santiagorobaldi/Arturito/DocumentacionLatex/avance-santi-2.tex

% Sección incluida desde ARTURITO MAIN.tex con \input{explicando_firmware.tex}.
% Mantener este archivo como fragmento: no agregar preámbulo ni \begin{document}.

% =============================================================================
\section{Diseño del firmware, simulación y depuración}
\label{sec:diseno-firmware}
% =============================================================================

\subsection{Alcance y arquitectura elegida}

El firmware actual corresponde a una primera versión de percepción (V0). En
esta etapa adquiere la velocidad angular del eje $Z$ de una IMU MPU6050 y una
distancia del sensor ToF VL53L0X, procesa ambas mediciones y transmite el estado
por el puerto serie. El ángulo se obtiene integrando el giroscopio; por ello
puede acumular deriva y no representa una pose absoluta.

La arquitectura es modular, organizada en tres capas, y utiliza tareas
periódicas planificadas por FreeRTOS. No es una arquitectura disparada por
eventos: las tareas repiten su ciclo con un período nominal de
\texttt{SAMPLE\_PERIOD\_MS = 30 ms}. FreeRTOS tiene planificación apropiativa por
prioridades; cada tarea cede el procesador al bloquearse durante la espera. La
adquisición de sensores y el procesamiento no quedan sincronizados en fase, por
lo que los 30 ms son un período nominal y no una garantía de latencia exacta.

\begin{center}
\fbox{\parbox{0.94\linewidth}{\centering
Sensores (I2C) $\rightarrow$ HAL de la placa $\rightarrow$ drivers compartidos
$\rightarrow$ tareas FreeRTOS $\rightarrow$ HAL serie $\rightarrow$ USB/UART
$\rightarrow$ Processing}}
\end{center}

El ciclo de operación puede resumirse con el siguiente pseudocódigo:

\begin{enumerate}
  \item Iniciar la consola serie y crear la tarea de arranque.
  \item Inicializar la MPU6050 y el VL53L0X mediante sus respectivas HAL.
  \item Si la IMU no responde, informar el error y no iniciar la adquisición.
        Si el ToF no responde, continuar e indicar distancia inválida.
  \item Calibrar el offset del giroscopio con el robot quieto y crear los
        mutexes que protegen las muestras compartidas.
  \item Crear las tareas periódicas de adquisición, procesamiento y publicación.
  \item Repetir: leer gyro Z y distancia; guardar una instantánea protegida;
        corregir e integrar gyro para estimar $\theta$; validar distancia;
        transmitir $\theta$ y distancia como una línea CSV.
\end{enumerate}

\subsection{Capas y módulos del firmware}

\begin{description}
  \item[Capa 1 --- HAL de hardware.] Los contratos comunes están en
        \texttt{shared/layer1\_hal/}. Las implementaciones específicas están en
        \texttt{esp32/src/layer1\_hal/} y
        \texttt{edu-ciaa/rover/src/layer1\_hal/}. La HAL de IMU inicializa y lee
        gyro Z en rad/s; la HAL ToF inicializa y devuelve metros o $-1$ si no hay
        una medida disponible; las HAL de tiempo y telemetría adaptan el reloj,
        las esperas y la salida serie de cada placa.
  \item[Capa 2 --- drivers.] Los módulos comunes
        \texttt{shared/layer2\_drivers/driver\_mpu6050.c} y
        \texttt{driver\_distancia.c} no acceden directamente a los periféricos.
        El primero promedia 1000 muestras para estimar el offset, aplica una
        zona muerta de $1^\circ$/s e integra gyro Z mediante integración
        trapezoidal. El segundo acepta distancias entre 0,05 m y 1,50 m,
        inclusive; fuera de ese intervalo informa $-1$.
  \item[Capa 3 --- aplicación.] \texttt{shared/layer3\_app/app\_runtime.c}
        inicializa el sistema, gestiona el estado y crea las tareas. La tarea
        \texttt{adquirir} obtiene las muestras de los sensores; \texttt{drivers}
        procesa la última muestra; y \texttt{publicar} genera la trama serie.
        Dos mutexes protegen las copias de datos crudos y procesados. La tarea
        de arranque inicializa sensores, calibra la IMU y crea las tareas
        cíclicas.
\end{description}

Las prioridades configuradas son 4 para arranque, 3 para adquisición, 2 para
procesamiento y 1 para publicación. Al terminar la inicialización, la tarea de
arranque se elimina. En ESP32, Arduino ya inició FreeRTOS antes de ejecutar
\texttt{setup()}; en EDU-CIAA, \texttt{main()} crea la tarea de arranque y luego
llama al scheduler.

\subsection{Bibliotecas y herramientas externas}

\begin{itemize}
  \item \textbf{ESP32:} framework Arduino para PlatformIO; FreeRTOS provisto
        por el entorno ESP32; \texttt{Wire} para el bus I2C; y biblioteca
        \texttt{Adafruit\_VL53L0X} para el ToF.
  \item \textbf{EDU-CIAA:} LPCOpen y SAPI para la placa y los periféricos,
        junto con el kernel FreeRTOS configurado en el proyecto. La HAL del
        VL53L0X realiza el acceso por registros I2C, sin depender de la
        biblioteca de Adafruit.
  \item \textbf{Código del proyecto:} contratos HAL, drivers MPU6050 y ToF, y
        runtime de aplicación compartidos entre plataformas. No se utiliza
        actualmente un RTOS del proyecto CIAA distinto de FreeRTOS.
  \item \textbf{PC:} Processing y su biblioteca Serial reciben la telemetría
        por USB/UART y dibujan la orientación y las lecturas de distancia.
\end{itemize}

\subsection{Formato de comunicación con el programa de PC}

El firmware de aplicación transmite a 115200 baudios una línea por muestra con
dos campos numéricos separados por coma:

\begin{center}
\texttt{theta\_rad,distancia\_m}
\end{center}

El ángulo se expresa en radianes y la distancia en metros. Las líneas de estado
y error comienzan con \texttt{\#}; el sketch de visualización las descarta. Una
distancia inválida se representa con $-1$. Este formato es un protocolo serie
de prueba V0, sin número de secuencia ni marca de tiempo.

\subsection{Interfaz de usuario y flujo de estados}

La interfaz de usuario actual es el sketch
\texttt{processing/flecha\_y\_mapa\_v1/flecha\_y\_mapa\_v1.pde}. No envía
órdenes al robot: presenta la orientación estimada, la distancia medida y una
nube polar acumulada de hasta 400 puntos. Los puntos se calculan respecto de un
origen fijo, suponiendo que el robot gira en el lugar. Por lo tanto, esta
interfaz permite observar sensores y telemetría, pero no muestra una grilla de
ocupación ni un mapa métrico con pose XY.

\begin{center}
\fbox{\parbox{0.88\linewidth}{\centering
Inicio del sketch $\rightarrow$ selección/configuración del puerto serie
$\rightarrow$ espera de tramas $\rightarrow$ \{línea de estado: actualizar
estado; trama CSV válida: dibujar orientación y distancia; trama inválida:
descartar\} $\rightarrow$ continuar recibiendo}}
\end{center}

El control START/STOP, la teleoperación y la selección entre navegación manual
y autónoma pertenecen a objetivos posteriores. No forman parte de la interfaz
ni del firmware V0 implementado.

\subsection{Ensayos, simulación y depuración}

La verificación realizada hasta ahora es experimental con el hardware y por
consola serie; no se cuenta con una simulación eléctrica o de movimiento del
rover. Para aislar periféricos existen entornos de prueba PlatformIO
\texttt{imu\_only}, \texttt{tof\_only} e \texttt{imu\_compare}. Este último
transmite tres campos (velocidad angular cruda, ángulo crudo integrado y ángulo
procesado) y se utiliza con
\texttt{processing/imu\_compare/imu\_compare.pde} para visualizar la diferencia
entre ambas integraciones. Ese formato de tres columnas es exclusivo de la
prueba y no coincide con el CSV de dos columnas de la aplicación V0.

El sketch \texttt{flecha\_y\_mapa\_v1} consume el CSV de la aplicación normal.
El monitor serie de PlatformIO debe cerrarse antes de abrir Processing, porque
ambos programas no pueden utilizar el mismo puerto simultáneamente. Los mensajes
de arranque permiten distinguir la inicialización de la IMU, el ToF, la
calibración y los errores.

Según el registro de avance del proyecto, los entornos de ESP32
\texttt{esp32dev}, \texttt{imu\_only} y \texttt{tof\_only} compilan, y una
versión anterior del firmware ESP32 fue probada con Processing. La versión
actualizada con runtime FreeRTOS compartido requiere confirmar nuevamente la
telemetría en serie después de su última modificación. El firmware EDU-CIAA
compila y enlaza, pero todavía no fue cargado ni ensayado con sensores en la
placa. No se incluyen capturas de resultados porque no hay imágenes de ensayos
registradas en los archivos del informe al momento de esta redacción.

\subsection{Alcance pendiente}

El firmware actual no implementa encoders, odometría de traslación, control de
motores, navegación autónoma, grilla de ocupación ni SLAM. El sensor ToF entrega
una medición puntual; el barrido angular mecánico y la asociación de cada medida
con una pose global deberán incorporarse para construir el mapa previsto. La
interfaz de usuario deberá ampliarse cuando se implementen los comandos remotos
y la visualización de dicho mapa.
