santiagorobaldi/Arturito/docs/ARTURITO MAIN.tex

\documentclass[12pt,a4paper]{article}
\usepackage[T1]{fontenc}
\usepackage[utf8]{inputenc}
\usepackage[spanish]{babel}
\usepackage{geometry}
\usepackage{graphicx}
\usepackage{xcolor}     % Para cuadros de texto y colores
\usepackage{tcolorbox} % Para cuadros de texto llamativos
\usepackage{microtype}  % Mejora la justificación tipográfica
\usepackage{caption}    % Personalización de pies de foto/figura
\usepackage{fancyhdr}   % Control de encabezados y pies de página
\usepackage{hyperref}   % Siempre se recomienda cargarlo al final del preámbulo
\usepackage{amsmath}    % Para \text en modo matemático
\usepackage{parskip}

% Configuración de márgenes
\geometry{
    top=2.5cm,
    bottom=2.5cm,
    left=3cm,
    right=2.5cm,
    headheight=15pt % <--- Agrega esta línea para eliminar el warning
}

% Definición de un rojo académico/elegante
\definecolor{rojoObjetivo}{RGB}{180, 40, 40}

% Configuración de formato para pies de figuras
\captionsetup{font=small, labelfont=bf}

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

% Configuración de hipervínculos
\hypersetup{
    colorlinks=true,
    linkcolor=black,
    urlcolor=blue,
    citecolor=black
}

\begin{document}
% Desactivar la división de palabras (hiphenación)
\hyphenpenalty=10000
\exhyphenpenalty=10000

% Permitir mayor flexibilidad en los espacios interpalabra para mantener el texto justificado
\tolerance=1000
\emergencystretch=3em

% ==============================================================================
% PORTADA / CARÁTULA PERSONALIZADA
% ==============================================================================
\begin{titlepage}
    \thispagestyle{empty}
    \centering

    \vspace*{1.5cm}

    % TÍTULO DEL INFORME
   {\huge \bfseries Arturito\\[0.3em] Rover autónomo diferencial mapeador \par}

    \vfill % Empuja el contenido hacia la parte inferior

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

    \vspace{1.5cm}

    % DATOS DE LA UNIVERSIDAD, DEPARTAMENTO Y FECHA
    \hrule height 0.5pt % Línea divisoria sutil
    \vspace{0.4cm}

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

\end{titlepage}

% ==============================================================================
% ÍNDICE GENERAL
% ==============================================================================
\pagenumbering{arabic}
\tableofcontents
\newpage

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

\newpage

% ==============================================================================
% SECCIÓN 2: OBJETIVOS
% ==============================================================================
\section{Objetivos}

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

% Recuadro destacado para la nota de los bloques en rojo
\noindent\fcolorbox{red!40}{red!5}{%
    \parbox{\dimexpr\linewidth-2\fboxsep-2\fboxrule\relax}{%
        \textbf{Nota:} Los bloques resaltados en \textcolor{red}{\textbf{rojo}} dentro del diagrama corresponden a funcionalidades clasificadas como \textbf{objetivos secundarios} del proyecto.
    }%
}
\vspace{0.4cm}

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

    \item \textbf{Bloque de Tracción y Actuación:} Recibe por parte del \textbf{Bloque de Procesamiento Central} comandos para regular la velocidad deseada de las ruedas, conviertiendo estas señales en tensión y corriente directas de la batería a los motores de dichas ruedas.
    \item \textbf{Bloque de Procesamiento Central:} Parte funcional del sistema encargada de: mapeo y estimación de posición, navegación y cinemática.

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

% ==============================================================================
% SECCIÓN 3: REQUERIMIENTOS
% ==============================================================================
\section{Requerimientos}

\subsection{Funcionales}

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

\end{itemize}

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

\subsection{No Funcionales}

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

\subsubsection{Restricciones Físicas}
\begin{itemize}
    \item El robot debe desplazarse a una velocidad lineal regulable entre \textit{[VelocidadMin]} y \textit{[VelocidadMax]}.
    \item El robot debe operar sobre pisos planos en interiores.
    \item El robot debe operar en un entorno donde los obstáculos tengan un mínimo de altura \textit{[AlturaMinObstaculos]}.
\end{itemize}
% ==============================================================================
% SECCIÓN 4: Cronograma Preliminar
% ==============================================================================
\section{Cronograma Preliminar}
% Agregar en el preámbulo si no los tenés:
% \usepackage{tcolorbox}
% \usepackage{hyperref}

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

% ==============================================================================
% SECCIÓN 5: División de Tareas del Grupo
% ==============================================================================
\section{División de Tareas del Grupo}

\begin{tcolorbox}[colframe=green!60!black, colback=green!5!white, arc=2mm, title=\textbf{División de tareas (Google Sheets)}]
  En el siguiente enlace podrá acceder a una plantilla con los modulos y requerimientos a realizar por integrante:
  \vspace{0.2cm}

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

% ==============================================================================
% SECCIÓN 5: Bibliografía
% ==============================================================================
\section{Bibliografía}

\begin{thebibliography}{99}

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

\end{thebibliography}

\end{document}
