santiagorobaldi/Arturito/DocumentacionLatex/Imagenes/Esquematico.pdf

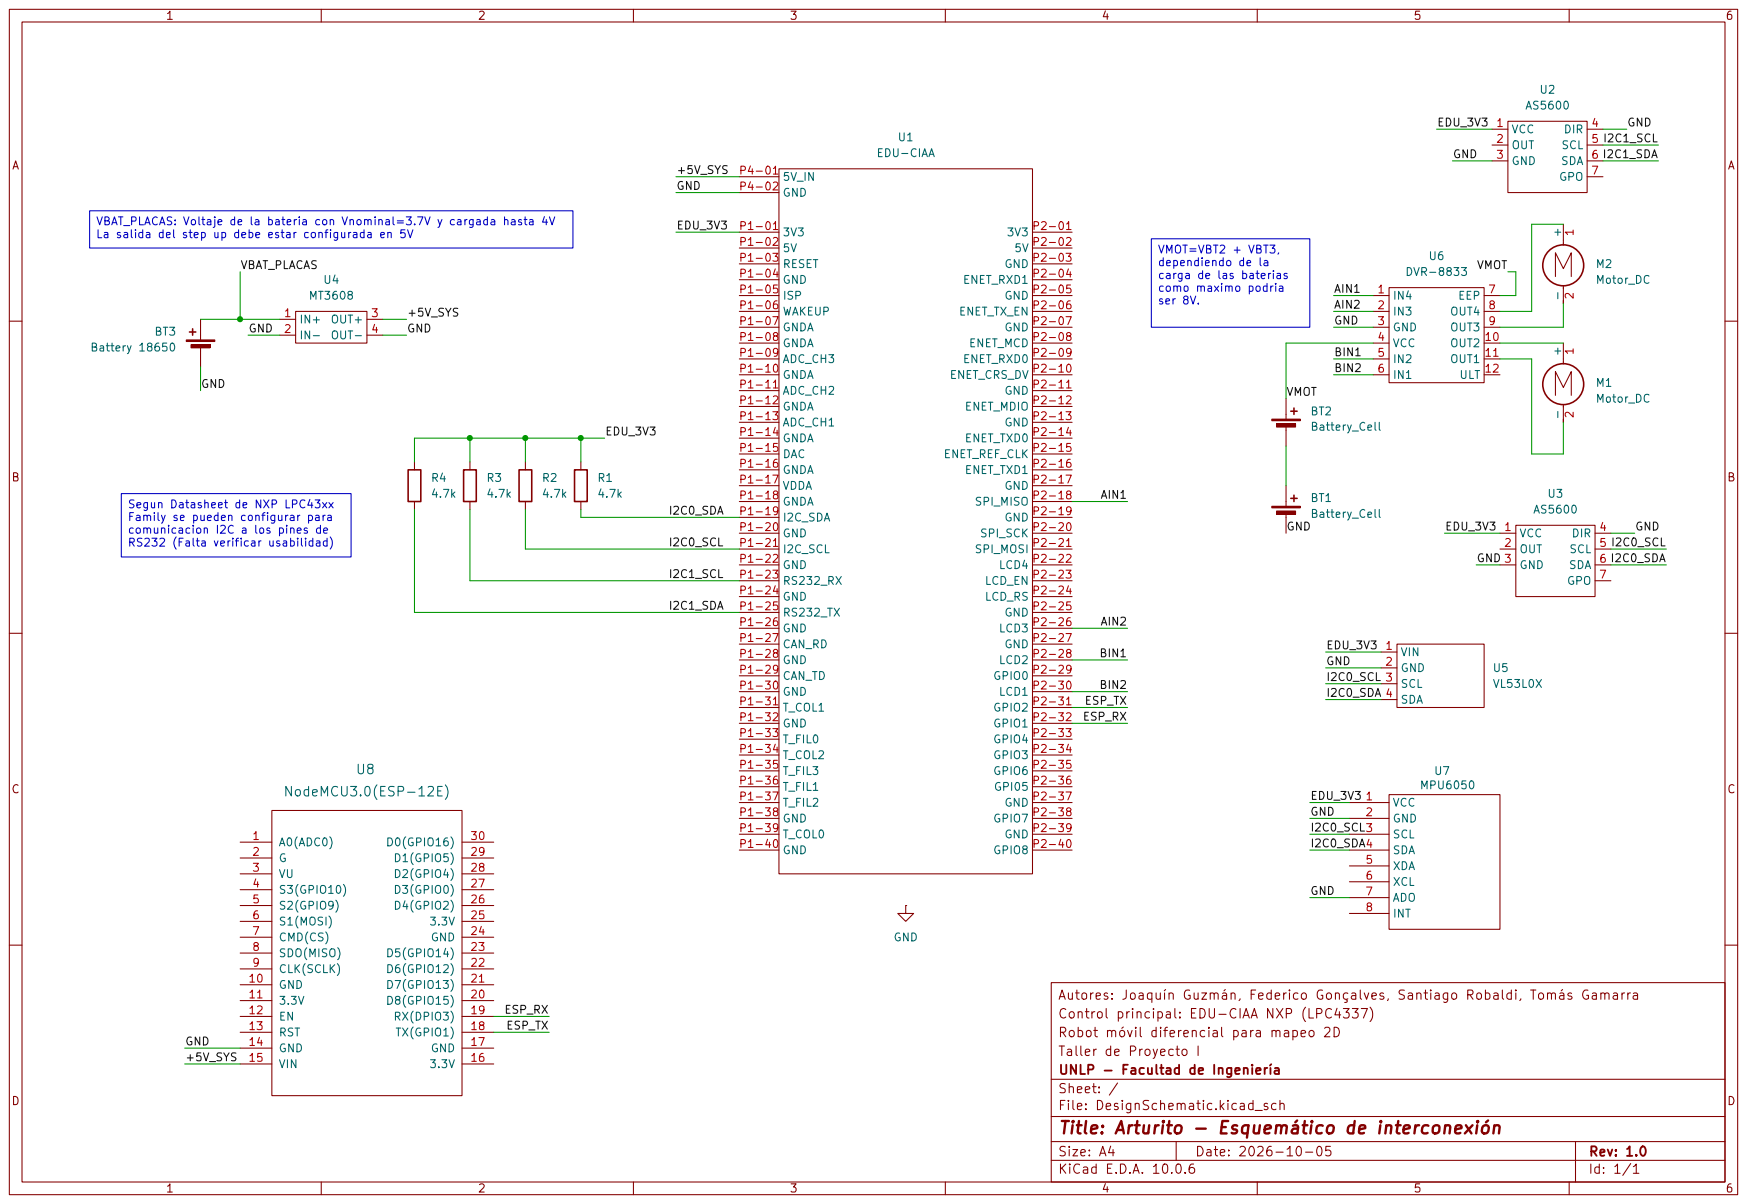
[picture p28: page 1]
