santiagorobaldi/Arturito/KiCad/DesignSchematic/DesignSchematic.kicad_sch

## KiCad design KiCad/DesignSchematic/DesignSchematic.kicad_sch (2026-10-06, an earlier design)

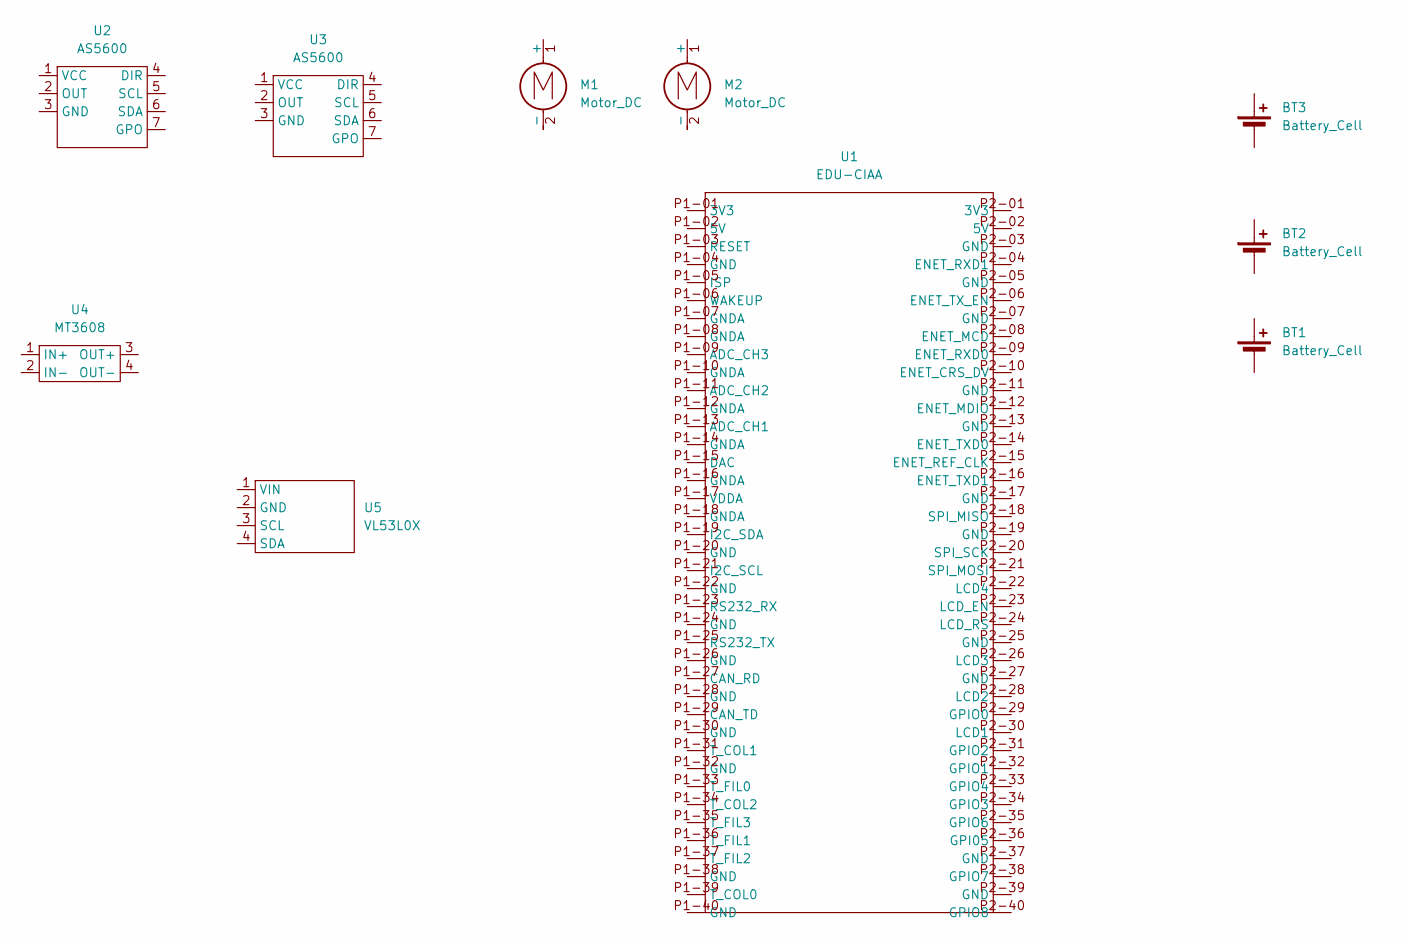
[picture p29: schematic DesignSchematic.kicad_sch]

Parts:
BT1, BT2, BT3: Battery_Cell
M1, M2: Motor_DC
U1: EDU-CIAA
U2, U3: AS5600
U4: MT3608
U5: VL53L0X
