santiagorobaldi/Arturito/(commit log)

2026-09-27 Initial commit: Estructura modular Arturito (ESP32 y EDU-CIAA)
    [lpc4337.cfg, lpc4337_new.cfg, lpc4337_old.cfg]
2026-09-27 processing para graficar
2026-09-28 refactoring de archivos para esp y actualizacion de driver mpu para usar el sensor al revez
2026-09-28 refactoring masivo
    [lpc4337.cfg, lpc4337_new.cfg, lpc4337_old.cfg]
2026-09-28 compila en edu-ciaa y en esp
    [lpc4337.cfg, lpc4337_new.cfg, lpc4337_old.cfg]
2026-09-28 FUNCIONA EN EDU-CIAA Y ESP32. EN TODO
2026-10-04 Cambios en .md y algunos simbolos en KiCad
    [DesignSchematic.kicad_pcb, DesignSchematic.kicad_sch]
2026-10-04 Se borra el .lck de KiCad, debería estar en el .gitignore
2026-10-04 Añadido el .lck al gitignore, módulo de motores esquematizado, y añadido el esquemático del NodeMCU
    [DesignSchematic.kicad_sch]
2026-10-04 Editado el EDU-CIAA para que los nombres de los pines se distingan
    [DesignSchematic.kicad_sch]
2026-10-05 Etiquetas para la entrada de alimentación de los microcontroladores
2026-10-06 Esquematico V1
    [DesignSchematic.kicad_sch]
2026-10-12 Antes de romper todo
2026-10-13 Mpu6050 Driver, Hal y odometry.c, falta verificar funcionamiento
2026-10-15 Driver vl53l0x (Falta validarlo)
2026-10-16 Actualizando sistema de archivos
2026-10-17 Funciona en esp32 - libreria modificada MPU6050
2026-10-17 Base para desarrollo de la feature de tracción
2026-10-17 Implementación básica de módulo de tracción con código de prototipo
2026-10-19 Termine de organizar docs latex
2026-10-21 Defino las funciones de driver y traction básicas
2026-10-21 Test de puente H igual que el prototipo de arturito
2026-10-21 Bloque de tracción con variables de velocidad de referencia para motores, función de set ref, y de tick para futuro freeRTOS. PID actualmente solo es wrapper de drv8833
2026-10-21 header de drv8833 ahora tiene enum para distinguir motores y un count para usar en la implementación
2026-10-21 antes de implementar hal_pwm
2026-10-22 fix de compilación, agrego saturación de pwm
2026-10-22 Saturación de velocidad, y flag para lazo de pid
2026-10-23 Falta las implementaciones de cada plataforma de las hals
2026-10-23 driver puente h ahora usa float para pwm
2026-10-23 implementación de hal_pwm en esp32
2026-10-23 Implementado hal_pwm_educiaa pero tiene un inconveniente. La implementación de PWM en sAPI utiliza como frecuencia de PWM fija 1kHZ. Eso para los motores produce ruido, y no se puede cambiar. Queda r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
2026-10-23 Se implementaron ambas opciones, la opción básica que no modifica la frecuencia, y la opción que sí modifica. Se deben testear ambas pero en teoría el modo básico debería de funcionar
